AK-Homberger/D1Mini-GasCounter/(threads)

Thread 3 (2023-05-09):

Compilation Error:Ö Multiple definitions of

alexloose, 2023-05-09:
Hi AK-Homberger, Teams,

I do get the following compilation error message:

`
C:\Users\XXX\AppData\Local\Arduino15\packages\esp8266\hardware\esp8266\3.1.2\cores\esp8266/time.cpp:28: multiple definition of `_Z12getLocalTimeP2tmj'; C:\Users\XXX\AppData\Local\Temp\arduino\sketches\AE7AE1529F0AC61DE62B2B28D03E0C2B\sketch\Gascounter.ino.cpp.o:C:\Users\alo\Downloads\D1Mini-GasCounter-main\Gascounter/Gascounter.ino:294: first defined here
collect2.exe: error: ld returned 1 exit status

exit status 1

Compilation error: exit status 1
`

This was solved by renaming the funtion getLocalTime to something else, e.g. getLocalTimeXXX and change all their references in code.

regards, Alexander

dervolki, 2023-05-09:
Hello,
I face exactly the same issue.
IDE is
Version: 2.1.0
Date: 2023-04-17T11:52:02.744Z
CLI Version: 0.32.2
Host is a M2MacBookPro
Os up to date.
Brew up to date.
URL: https://arduino.esp8266.com/stable/package_esp8266com_index.json

dervolki, 2023-05-09:
quick update:

installed old IDE
IDE: 1.8.19
Same board URL.

result in the same error

`/Users/volker/Library/Arduino15/packages/esp8266/tools/xtensa-lx106-elf-gcc/3.1.0-gcc10.3-e5f9fec/bin/../lib/gcc/xtensa-lx106-elf/10.3.0/../../../../xtensa-lx106-elf/bin/ld: /var/folders/8k/p_4lnp0s08334wxf6fvhwwvm0000gn/T/arduino_cache_836220/core/core_c48fcb446ccceeddd4e2a94e9818c5d5.a(time.cpp.o): in function `_Z12getLocalTimeP2tmj':
/Users/volker/Library/Arduino15/packages/esp8266/hardware/esp8266/3.1.2/cores/esp8266/time.cpp:28: multiple definition of `_Z12getLocalTimeP2tmj'; sketch/Gascounter.ino.cpp.o:/Users/volker/D1Mini-GasCounter/Gascounter/Gascounter.ino:294: first defined here
collect2: error: ld returned 1 exit status
exit status 1
Error compiling for board LOLIN(WEMOS) D1 R2 & mini.`

dervolki, 2023-05-10:
Hello,
I dowloaded Yesterday and apperently this worked fine for me.
Thanks a  lot for your help

alexloose, 2023-05-10:
Hi,
that's also what I did. works for me

Closed 2023-05-10.

Thread 5 (2023-05-12):

Different Compilation error

Linux2fast, 2023-05-12:
Hello,

various errors are generated when compiling the code via the Arduino IDE 2.1.x.
D5 was not declared in this scope
MAIN_PAGE was not declared in this scope

The code and all devices are from your github page.
All libraries and dependencies are installed and present

Have you any Idea for this Problem?

Thanks for your Help

AK-Homberger, 2023-05-12:
If D5 is not declared, you are using probably a wrong Bord information.
You have to use ESP8266 (D1 Mini).

Linux2fast, 2023-05-12:
Thanks for your Help!
Thats the Solution!

Thread 7 (2023-06-28):

Sensor wird in iobroker nicht angezeigt

bear1180, 2023-06-28:
Hallo, ich bekomme nach erfolgreicher Installation keine Daten im iob angezeigt. Ich vermute es liegt am mqtt Benutzer und/oder matt Passwort. Hier habe ich aber nicht herausfinden können, wie diese Information im Sketch mitgegeben werden müssen. Hatte es wie im Sketch angegeben versucht, leider lief dies bereits in der arduino IDE auf einen Fehler.

AK-Homberger, 2023-06-29:
Im Sketch wird kein Benutzer/Passwort für MQTT benutzt. Warum auch im Heimatnetz. Stimmt denn die IP-Adresse für den Server (mqtt_server)?

bear1180, 2023-06-29:
Danke für die Rückmeldung. Im iobroker habe ich allerdings einen Benutzer in der mqtt Instanz hinterlegt. Die IP-Adresse von iob ist auch korrekt. Selbst den Port habe ich korrigiert, da der Port aus den Sketch von sonoff belegt ist. :( Werde heute Abend nochmals mit einem ruhigen Auge drauf schauen. VG

AK-Homberger, 2023-06-29:
Dann muss man natürlich auch Benutzername/Passwort im Client mit angeben. Einfach bei der Dokumentation zum PubSub-Client nachsehen.

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

bear1180, 2023-06-29:
Sorry, muss doch nochmal nachfragen. Ist es diese Stelle im Sketch?

Also:
    if (client.connect(clientId,Abc,test123.c_str()))

Aber was ist mit dem Teil ".c_str()))"?

Besten Dank

//if you MQTT broker has clientID,username and password
    //please change following line to    if (client.connect(clientId,userName,passWord))
    if (client.connect(clientId.c_str()))

AK-Homberger, 2023-07-02:
".c_str()" wird benötigt, um aus einem "Srting" (C++) ein Array of Char zu machen. Die klassische Art eine Zeichenkette in C auszudrücken. Wenn man zusätzlic userName und passWord angeben möchte einfach die beiden Werte in Hochkomma (") eintragen.

Thread 11 (2023-12-11):

Bouncing/Prellen

arazok, 2023-12-11:
Hi,
sometimes the value is not exactly as the gas meter shows. That could be bouncing / prellen if the reed contact is near the magnet and no active gas flow.
Any ideas to solve this issue ?

AK-Homberger, 2023-12-12:
Hi,

Unfortunately I don't have experience with the reed contact version, because I'm using the active inductive sensor at home. Within the interrupt code, I added protection against "fast" bouncing:

_if (millis() - Last_int_time > 100) { // Debouncing 100 ms for reed contact_

But this will not protect against "slow" bouncing of the reed contact, when there is no gas flow.

I would try to change the position of the contact or to use a different type with a bigger hysteresis.

Regards,
Andreas

Closed 2025-09-22.
