AK-Homberger/D1Mini-GasCounter/(commit log)

2023-02-13 Version 1.3: Debouncing interrupt as preparation for reed contact.
2023-05-09 Changed function name to "MyGetLocalTime" to avoid duplicate definition problem.
    Changed function name to "MyGetLocalTime" to avoid duplicate definition problem. See issues for details.
    [Gascounter.ino]
2024-11-13 Add files via upload
    Corrected pointer type from unsigned to signed. To avoid wrong hour average vallue once per hour.
    [Gascounter.ino]
